will7007/Sweet-Potato-Sensor/433 Mhz Module/Readme.md

# 433 Mhz (and 315 Mhz) Modules
We used [these](https://www.amazon.com/UCEC-XY-MK-5V-Transmitter-Receiver-Raspberry/dp/B017AYH5G0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) cheap 433 Mhz Tx/Rx modules from Amazon for our tests. We also used [these](https://www.amazon.com/dp/B07415XCSD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) 315 Mhz modules as well, which are pin/code compatible with the 433 Mhz modules. While these modules are very cheap, they also aren't very reliable (especially on the AtTiny85, where the RadioHead library doesn't seem to work), are very slow (the Manchester Encoding library is limited to about 300 baud on the AtTiny85 at 1 Mhz), and have almost no documentation available for them. They also didn't transmit very far from the sweet potato containers: we were able to get 8 feet of range when the transmitter was under about a one-foot-pile of sweet potatoes.

The code included here utilizes modified example code/header files from the [Manchester Encoding library](https://github.com/mchr3k/arduino-libs-manchester), the [BME280 I2C library](https://www.14core.com/wiring-the-bme280-environmental-sensor-using-i2cspi-interface-with-microcontroller/), and the [TinySnore Library](https://github.com/connornishijima/TinySnore).

The Manchester Encoding library is not licensed. As such, I have encluded it here through Github's policy regarding the forking/cloning of unlicensed code. Note that this code no longer needs to be used in this non-commercial research project and it is included solely for the purposes of thorough prototype documentation as opposed to distribution.

The BME280 library code is licensed under the Creative Commons Attribution Non-Commercial 3.0 License (http://creativecommons.org/licenses/by-nc-sa/3.0/).

The TinySnore library is licensed under the GPL. I have encluded the GPL in the LICENSE file in this folder.
