will7007/Sweet-Potato-Sensor/(commit log)

2019-05-31 Initial commit, first steps with temperature sensor
    Temperature sensor is working but I think it is off by 5+ degrees (although we do not have an exact measurement of the room temperature, the temperature read by the AtTiny85 differs from the temperature recorded on the Arduino Mega by 10 degrees).
2019-06-03 Set forced mode, added RX/TX support for the 433Mhz set
    I will create separate project folders for each of the different RX/TX pairs tomorrow. Today I resolved the timing issue with the AtTiny85 by burning the bootloader, and experimented with a different AtTiny hardware core (which kept getting seg faults when compiling nothing). In this code, I've applied forced mode (which appears to make the temperature reading more accurate) and am utilizing the VirtualWire library to work with the cheap 433Mhz RF modules.
2019-06-04 Switched libraries and fixed forced mode readings
    Changed to the manchester encoding library since the other ones wouldn't work at 1Mhz and were also causing the delay() function to stop working on the AtTiny. Am still able to send from one side of the lab to the other, though tomorrow I plan on installing an antenna. Forced mode readings were also fixed--the sensor must be placed into forced mode each time that you want the reading to be updated (since it is stored), which I didn't realize until I read the datasheet more thoroughly. Humidity readings need to be fixed as they are very inaccurate and are fluctuating wildly.
    [433Tx_Tiny_BME280.ino]
2019-06-04 Receiving Arduino code
    Thanks to https://www.instructables.com/id/Attiny85-RF-Transmitter-to-Arduino-Uno-Receiver-Ma/ and http://mchr3k.github.io/arduino-libs-manchester/ (official documentation) for providing code which fixes the example receiving code.
2019-06-07 Humidity finally working with new library
    After spending all day unsuccessfully trying to debug and rewrite the TinyBME280 library so it would correctly report humidity, I decided to spend more time looking for an alternate library. I finally found this library from https://www.14core.com/wiring-the-bme280-environmental-sensor-using-i2cspi-interface-with-microcontroller/ which apparently is able to read the humidity and temperature correctly (something I still find hard to believe)!
    [433Tx_Tiny_BME280.ino]
2019-06-11 Changed baud rate to 300
    A baud rate of 300 really improved the amount of successfully received packets at both short and long distances, so I've changed it
    [433Tx_Tiny_BME280.ino]
2019-06-11 Made serial output look better, still some issues
    Current issue: The type of data received (the sensor address, the temperature) cannot be decided by the receiver in case of a blip in the data, which would offset the type of information being sent (if the humidity is missed, then the next value that comes in will be printed as the humidity).
2019-06-12 Create AtMega_RFID_Tag_Test
    Code to test the ST25DV04K. The existing library for this chip requires several other libraries to work and is too complicated for what I'm trying to do, so I'm making my own functions instead. Presenting the I2C password successfully unlocks protected mode (according to the register) and I've verified that the program is able to read some various normal registers.
2019-06-14 Slowed down transmit speed, added data identifiers
    I slowed down the transmit speed so that other sensors could have time to receive the signal and then send it out again without missing any packets. I also removed the forcedMeasurement() method as it wasn't being used, but I will likely need it in the future.
    [433Tx_Tiny_BME280.ino]
2019-06-14 Code to test inter-sensor communication/signal repeating
2019-06-18 Added receiving buffer and transmit triggering button
2019-06-24 Added sending/receiving of sensor readings
    LED removed as there wasn't any free pin for it on the AtTiny85 when everything else is plugged in (excluding PB5, the reset pin).
2019-06-24 Added Tx of fake sensor data and serial-activated transmitting
    Any character sent over serial will cause the fake sensor data to be sent: the Serial.read() is only to flush out the character that's been received.
2019-06-25 Buffer now transmits automatically when an EOF is received
    Though the sensor circuit is having problems transmitting from the sensor while the receiver is in the same circuit, this code works at close distances.
    [Tiny_Tx_Rx_BME280.ino]
2019-06-26 Changed to transmit only with two transmitting modes
    When the switch is off, the sensor will transmit in brief mode, where the sensor will send out an "okay" pulse and its address (currently it sends this out 5 times). When the switch is on, the sensor sends out its readings like normal. The sensor was able to send a good distance from within a plastic shell with a power supply of 3 AA batteries.
2019-07-02 Shortened Tx delay, changed switch function to lengthen delay
    [433Tx_Tiny_BME280.ino]
2019-07-02 Shortened/added delays for sending
    [Tiny_Tx_Rx_BME280.ino]
2019-07-05 Transmit function changed to byte array
    Do not use man.workAround1MhzTinyCore(), it will cause the program to transmit the array too quickly (likely 8x as fast). Also, make sure the first byte of your data array is the number of bytes that will be transmitted.
    [Tiny_Tx_Rx_BME280.ino]
2019-07-05 Base station now transmits/receives arrays of bytes
    I have not tested the fake sensor data transmitting portion of the code, but it should work as it came from the previous single-byte version of this code.
    Turns out the example wasn't broken after all--you just need to include the number of bytes being sent (including the size byte) in the first element of the transmitted array.
    [Base_Station.ino]
2019-07-09 Sleep mode/interupt added, but Tx/Rx broken
    The sensor does not seem to properly receive the transmission with this code, but I've uploaded it because the sleep function/level-trigger awakening seems to be working fine.
    [Tiny_Tx_Rx_BME280.ino]
2019-07-10 Interrupts now work
    This code may not be very useful in the future, as keeping the receiver on all the time to listen for a starting signal will drain too much power. (The receiver uses about 0.00473A while I measured the sleeping AtTiny85 using around 420nA)
    [Tiny_Tx_Rx_BME280.ino]
2019-07-11 Dynamic sleep period based on time between messages
    Looks like I was able to keep in the level-triggered interrupt after all: this code is a two-state program which records the delay between transmissions initially, then uses that measured delay to control two periods of sleep (one with the transmitter off and one with it on).
2019-08-01 Working sender code for the AtTiny85 + Rx code
    Uses the library/example code from https://github.com/sandeepmistry/arduino-LoRa. Compiled with Spence Konde's AtTiny core.
2019-08-02 Revert "Update 433_Tiny_LoRaSender.ino"
    This reverts commit cf45ed608528c36889600076f47432615c77f52d.
    [433_Tiny_LoRaSender.ino]
2019-08-15 From https://github.com/sandeepmistry/arduino-LoRa
2019-08-15 Create LICENSE (wire library)
